PabloCamachoo/front-endPablo/TFG-V1.kicad_pcb

## KiCad design TFG-V1.kicad_pcb (2025-01-17)

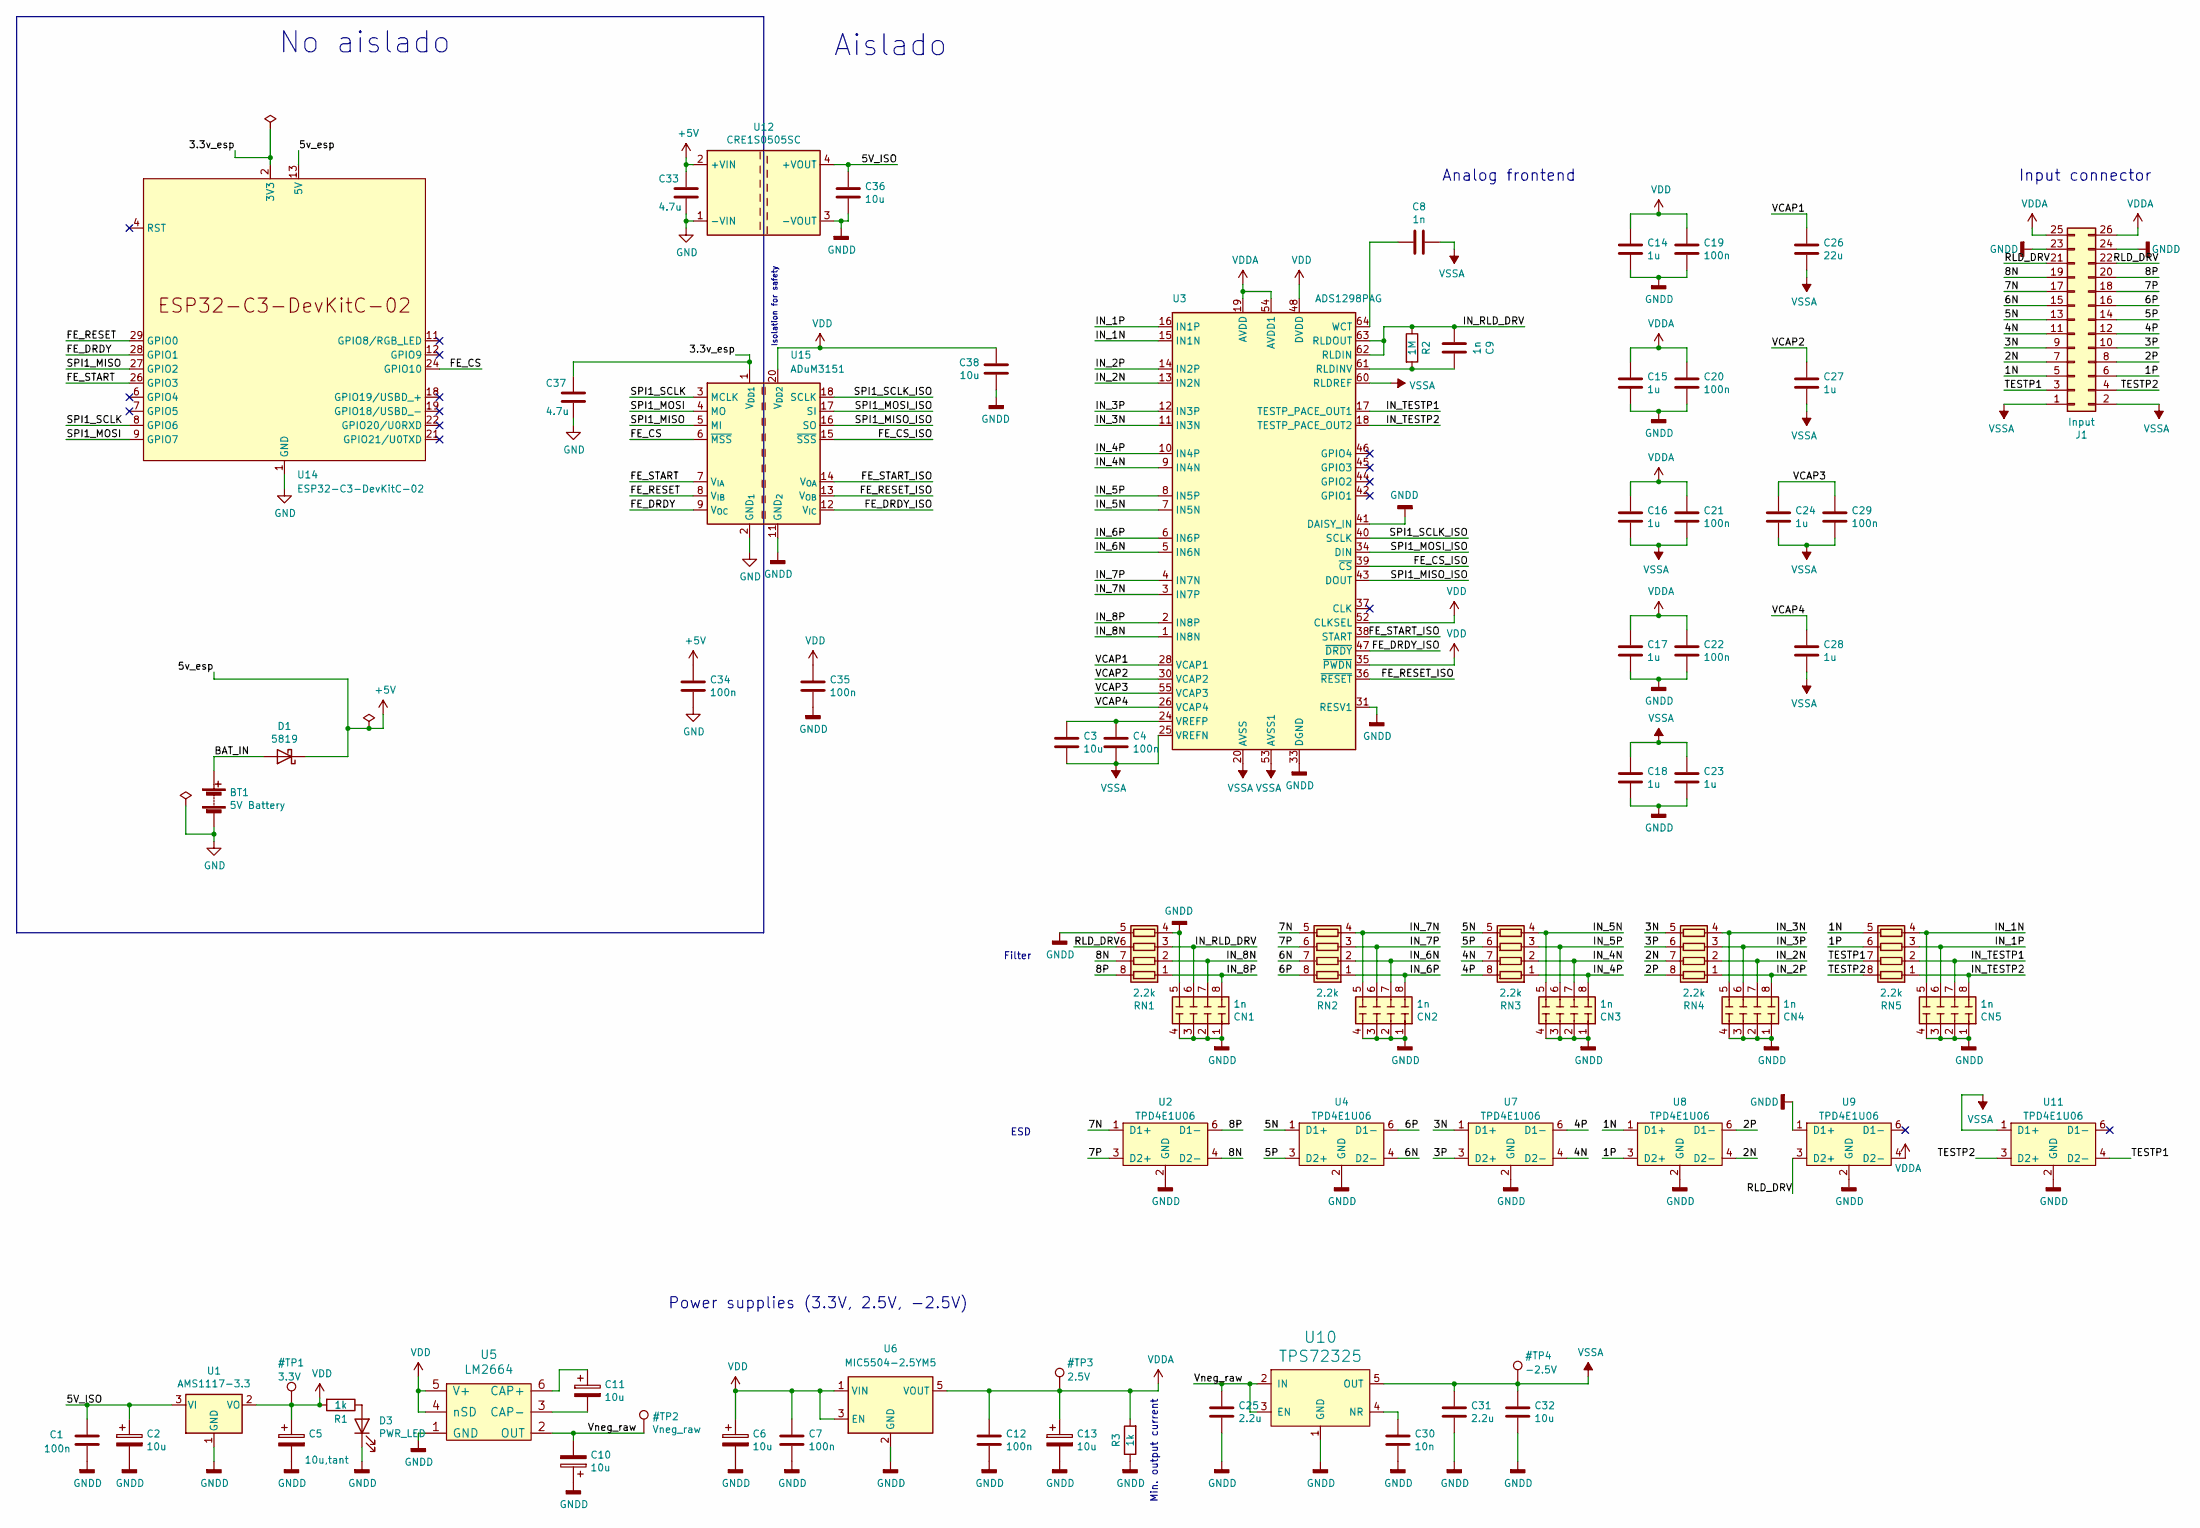
[picture p1: schematic TFG-V1.kicad_sch]

Parts:
BT1: 5V Battery; PinHeader_1x02_P2.54mm_Vertical
C1, C4, C7, C12, C19, C20, C21, C22, C29, C34, C35: 100n; C_0805_2012Metric_Pad1.18x1.45mm_HandSolder; LCSC C476766
C2, C3, C6, C10, C11, C13, C32, C36, C38: 10u; C_0805_2012Metric_Pad1.18x1.45mm_HandSolder; LCSC C40894
C5: 10u,tant; C_0805_2012Metric_Pad1.18x1.45mm_HandSolder; LCSC C110055
C8, C9: 1n; C_0805_2012Metric_Pad1.18x1.45mm_HandSolder; LCSC C277515
C14, C15, C16, C17, C18, C23, C24, C27, C28: 1u; C_0805_2012Metric_Pad1.18x1.45mm_HandSolder; LCSC C28323
C25, C31: 2.2u; C_0805_2012Metric_Pad1.18x1.45mm_HandSolder; LCSC C87994
C26: 22u; C_0805_2012Metric_Pad1.18x1.45mm_HandSolder; LCSC C129302
C30: 10n; C_0805_2012Metric_Pad1.18x1.45mm_HandSolder; LCSC C52278
C33, C37: 4.7u; C_0805_2012Metric_Pad1.18x1.45mm_HandSolder; LCSC C1779
CN1, CN2, CN3, CN4, CN5: 1n; R_Array_Convex_4x0603; LCSC C507409
D1: 5819; D_SOD-123; LCSC C82544
D3: PWR_LED; LED_0805_2012Metric; LCSC C72037
J1: Input; PinHeader_2x13_P2.54mm_Vertical; LCSC C358714
R1, R3: 1k; R_0805_2012Metric; LCSC C17513
R2: 1M; R_0805_2012Metric; LCSC C17514
RN1, RN2, RN3, RN4, RN5: 2.2k; R_Array_Convex_4x0603; LCSC C12001
U1: AMS1117-3.3; SOT-223-3_TabPin2; LCSC C6186
U2, U4, U7, U8, U9, U11: TPD4E1U06; SOT-23-6; LCSC C124691
U3: ADS1298PAG; TQFP-64_10x10mm_P0.5mm
U5: LM2664; SOT-23-6; LCSC C108573
U6: MIC5504-2.5YM5; SOT-23-5
U10: TPS72325; SOT-23-5; LCSC C69932
U12: CRE1S0505SC; Converter_DCDC_Murata_CRE1xxxxxxSC_THT; LCSC C18424
U14: ESP32-C3-DevKitC-02
U15: ADuM3151; SSOP-20_5.3x7.2mm_P0.65mm

Connections:
3V3: C37.1, U14.2 (3V3), U14.3 (3V3), U15.1 (V_{DD1})
+5V: C33.1, C34.1, D1.1 (K), U12.2 (+VIN), U14.13 (5V), U14.14 (5V)
/1N: J1.5, RN5.5 (R4.2), U8.1 (D1+)
/1P: J1.6, RN5.6 (R3.2), U8.3 (D2+)
/2N: J1.7, RN4.7 (R2.2), U8.4 (D2-)
/2P: J1.8, RN4.8 (R1.2), U8.6 (D1-)
/3N: J1.9, RN4.5 (R4.2), U7.1 (D1+)
/3P: J1.10, RN4.6 (R3.2), U7.3 (D2+)
/4N: J1.11, RN3.7 (R2.2), U7.4 (D2-)
/4P: J1.12, RN3.8 (R1.2), U7.6 (D1-)
/5N: J1.13, RN3.5 (R4.2), U4.1 (D1+)
/5P: J1.14, RN3.6 (R3.2), U4.3 (D2+)
/5V_ISO: C1.1, C2.1, C36.1, U1.3 (VI), U12.4 (+VOUT)
/6N: J1.15, RN2.7 (R2.2), U4.4 (D2-)
/6P: J1.16, RN2.8 (R1.2), U4.6 (D1-)
/7N: J1.17, RN2.5 (R4.2), U2.1 (D1+)
/7P: J1.18, RN2.6 (R3.2), U2.3 (D2+)
/8N: J1.19, RN1.7 (R2.2), U2.4 (D2-)
/8P: J1.20, RN1.8 (R1.2), U2.6 (D1-)
/BAT_IN: BT1.1 (+), D1.2 (A)
/FE_CS: U14.24 (GPIO10), U15.6 (~MSS)
/FE_CS_ISO: U3.39 (~CS), U15.15 (~SSS)
/FE_DRDY: U14.28 (GPIO1), U15.9 (V_{OC})
/FE_DRDY_ISO: U3.47 (~DRDY), U15.12 (V_{IC})
/FE_RESET: U14.29 (GPIO0), U15.8 (V_{IB})
/FE_RESET_ISO: U3.36 (~RESET), U15.13 (V_{OB})
/FE_START: U14.26 (GPIO3), U15.7 (V_{IA})
/FE_START_ISO: U3.38 (START), U15.14 (V_{OA})
/IN_1N: CN5.5 (R4.2), RN5.4 (R4.1), U3.15 (IN1N)
/IN_1P: CN5.6 (R3.2), RN5.3 (R3.1), U3.16 (IN1P)
/IN_2N: CN4.7 (R2.2), RN4.2 (R2.1), U3.13 (IN2N)
/IN_2P: CN4.8 (R1.2), RN4.1 (R1.1), U3.14 (IN2P)
/IN_3N: CN4.5 (R4.2), RN4.4 (R4.1), U3.11 (IN3N)
/IN_3P: CN4.6 (R3.2), RN4.3 (R3.1), U3.12 (IN3P)
/IN_4N: CN3.7 (R2.2), RN3.2 (R2.1), U3.9 (IN4N)
/IN_4P: CN3.8 (R1.2), RN3.1 (R1.1), U3.10 (IN4P)
/IN_5N: CN3.5 (R4.2), RN3.4 (R4.1), U3.7 (IN5N)
/IN_5P: CN3.6 (R3.2), RN3.3 (R3.1), U3.8 (IN5P)
/IN_6N: CN2.7 (R2.2), RN2.2 (R2.1), U3.5 (IN6N)
/IN_6P: CN2.8 (R1.2), RN2.1 (R1.1), U3.6 (IN6P)
/IN_7N: CN2.5 (R4.2), RN2.4 (R4.1), U3.3 (IN7P)
/IN_7P: CN2.6 (R3.2), RN2.3 (R3.1), U3.4 (IN7N)
/IN_8N: CN1.7 (R2.2), RN1.2 (R2.1), U3.1 (IN8N)
/IN_8P: CN1.8 (R1.2), RN1.1 (R1.1), U3.2 (IN8P)
/IN_RLD_DRV: C9.2, CN1.6 (R3.2), R2.1, RN1.3 (R3.1), U3.62 (RLDIN), U3.63 (RLDOUT)
/IN_TESTP1: CN5.7 (R2.2), RN5.2 (R2.1), U3.17 (TESTP_PACE_OUT1)
/IN_TESTP2: CN5.8 (R1.2), RN5.1 (R1.1), U3.18 (TESTP_PACE_OUT2)
/RLD_DRV: J1.21, J1.22, RN1.6 (R3.2), U9.3 (D2+)
/SPI1_MISO: U14.27 (GPIO2), U15.5 (MI)
/SPI1_MISO_ISO: U3.43 (DOUT), U15.16 (SO)
/SPI1_MOSI: U14.9 (GPIO7), U15.4 (MO)
/SPI1_MOSI_ISO: U3.34 (DIN), U15.17 (SI)
/SPI1_SCLK: U14.8 (GPIO6), U15.3 (MCLK)
/SPI1_SCLK_ISO: U3.40 (SCLK), U15.18 (SCLK)
/TESTP1: J1.3, RN5.7 (R2.2), U11.4 (D2-)
/TESTP2: J1.4, RN5.8 (R1.2), U11.3 (D2+)
/VCAP1: C26.1, U3.28 (VCAP1)
/VCAP2: C27.1, U3.30 (VCAP2)
/VCAP3: C24.1, C29.1, U3.55 (VCAP3)
/VCAP4: C28.1, U3.26 (VCAP4)
/Vneg_raw: C10.2, C25.1, U5.2 (OUT), U10.2 (IN), U10.3 (EN)
GND: BT1.2 (-), C33.2, C34.2, C37.2, U12.1 (-VIN), U14.1 (GND), U14.5 (GND), U14.10 (GND), U14.15 (GND), U14.16 (GND), U14.17 (GND), U14.20 (GND), U14.23 (GND), U14.25 (GND), U14.30 (GND), U15.2 (GND_{1}), U15.10 (GND_{1})
GNDD: C1.2, C2.2, C5.2, C6.2, C7.2, C10.1, C12.2, C13.2, C14.2, C15.2, C17.2, C18.2, C19.2, C20.2, C22.2, C23.2, C25.2, C30.2, C31.2, C32.2, C35.2, C36.2, C38.2, CN1.1 (R1.1), CN1.2 (R2.1), CN1.3 (R3.1), CN1.4 (R4.1), CN1.5 (R4.2), CN2.1 (R1.1), CN2.2 (R2.1), CN2.3 (R3.1), CN2.4 (R4.1), CN3.1 (R1.1), CN3.2 (R2.1), CN3.3 (R3.1), CN3.4 (R4.1), CN4.1 (R1.1), CN4.2 (R2.1), CN4.3 (R3.1), CN4.4 (R4.1), CN5.1 (R1.1), CN5.2 (R2.1), CN5.3 (R3.1), CN5.4 (R4.1), D3.1 (K), J1.23, J1.24, R3.1, RN1.4 (R4.1), RN1.5 (R4.2), U1.1 (GND), U2.2 (GND), U3.31 (RESV1), U3.33 (DGND), U3.41 (DAISY_IN), U3.49 (DGND), U3.51 (DGND), U4.2 (GND), U5.1 (GND), U6.2 (GND), U7.2 (GND), U8.2 (GND), U9.1 (D1+), U9.2 (GND), U10.1 (GND), U11.2 (GND), U12.3 (-VOUT), U15.11 (GND_{2}), U15.19 (GND_{2})
unnamed: D3.2 (A), R1.1
unnamed: C9.1, R2.2, U3.61 (RLDINV)
unnamed: C3.1, C4.1, U3.24 (VREFP)
unnamed: C8.2, U3.64 (WCT)
unnamed: C11.1, U5.6 (CAP+)
unnamed: C11.2, U5.3 (CAP-)
unnamed: C30.1, U10.4 (NR)
VDD: C5.1, C6.1, C7.1, C14.1, C19.1, C35.1, C38.1, R1.2, U1.2 (VO), U3.35 (~PWDN), U3.48 (DVDD), U3.50 (DVDD), U3.52 (CLKSEL), U5.4 (nSD), U5.5 (V+), U6.1 (VIN), U6.3 (EN), U15.20 (V_{DD2})
VDDA: C12.1, C13.1, C15.1, C16.1, C17.1, C20.1, C21.1, C22.1, J1.25, J1.26, R3.2, U3.19 (AVDD), U3.21 (AVDD), U3.22 (AVDD), U3.54 (AVDD1), U3.56 (AVDD), U3.59 (AVDD), U6.5 (VOUT), U9.4 (D2-)
VSSA: C3.2, C4.2, C8.1, C16.2, C18.1, C21.2, C23.1, C24.2, C26.2, C27.2, C28.2, C29.2, C31.1, C32.1, J1.1, J1.2, U3.20 (AVSS), U3.23 (AVSS), U3.25 (VREFN), U3.32 (AVSS), U3.53 (AVSS1), U3.57 (AVSS), U3.58 (AVSS), U3.60 (RLDREF), U10.5 (OUT), U11.1 (D1+)

Notes on the sheet:
Analog frontend
Aislado
Input connector
Isolation for safety
Min. output current
Filter
Power supplies (3.3V, 2.5V, -2.5V)
ESD
No aislado

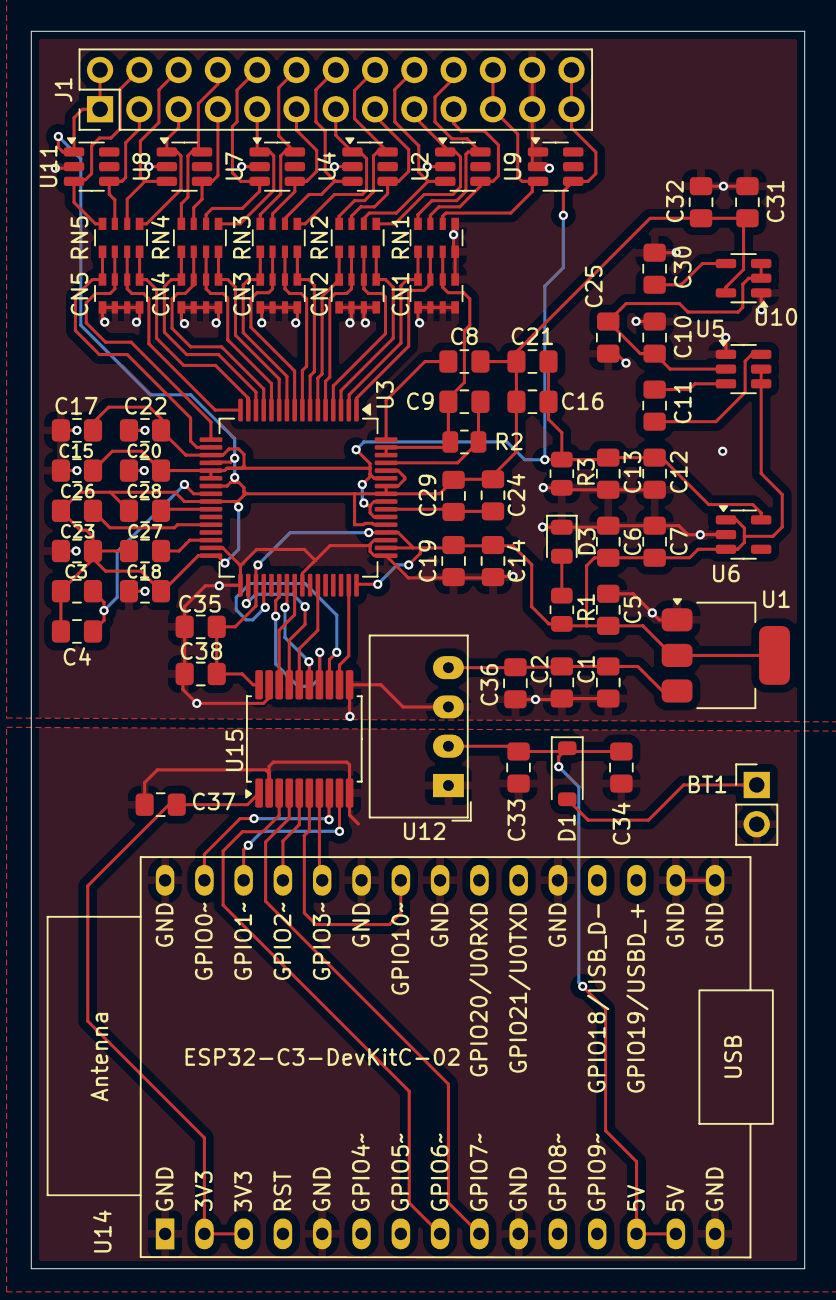
[picture p2: board TFG-V1.kicad_pcb from above]

Board: 2 copper layers, 50.0 x 80.0 mm, 69 parts (0 on the bottom side), 73 nets.
