PabloCamachoo/front-endPablo/(commit log)

2025-01-10 correcciones varias 1
    reruteo y corregir algunas cosas
    [TFG-V1.kicad_pcb, TFG-V1.kicad_sch]
2025-01-17 diseño final
    [TFG-V1.kicad_pcb, TFG-V1.kicad_sch]
